bdshaffer73/RCBrains/Photos/IMG_20170501_142741.jpg

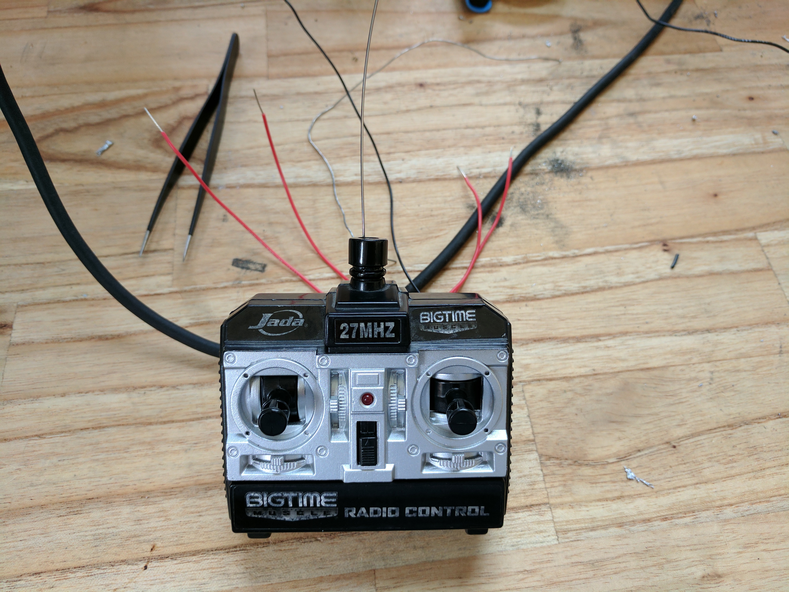
Photos/IMG_20170501_142741.jpg
