bdshaffer73/RCBrains/Photos/IMG_20170501_141757.jpg

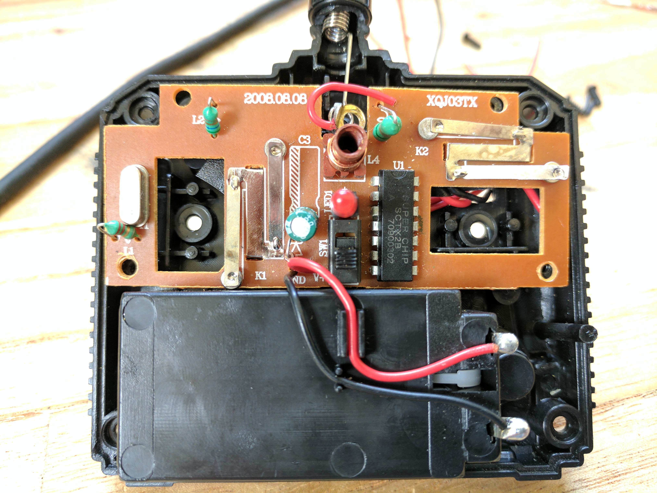
Photos/IMG_20170501_141757.jpg
