bdshaffer73/RCBrains/Photos/IMG_20170501_141855.jpg

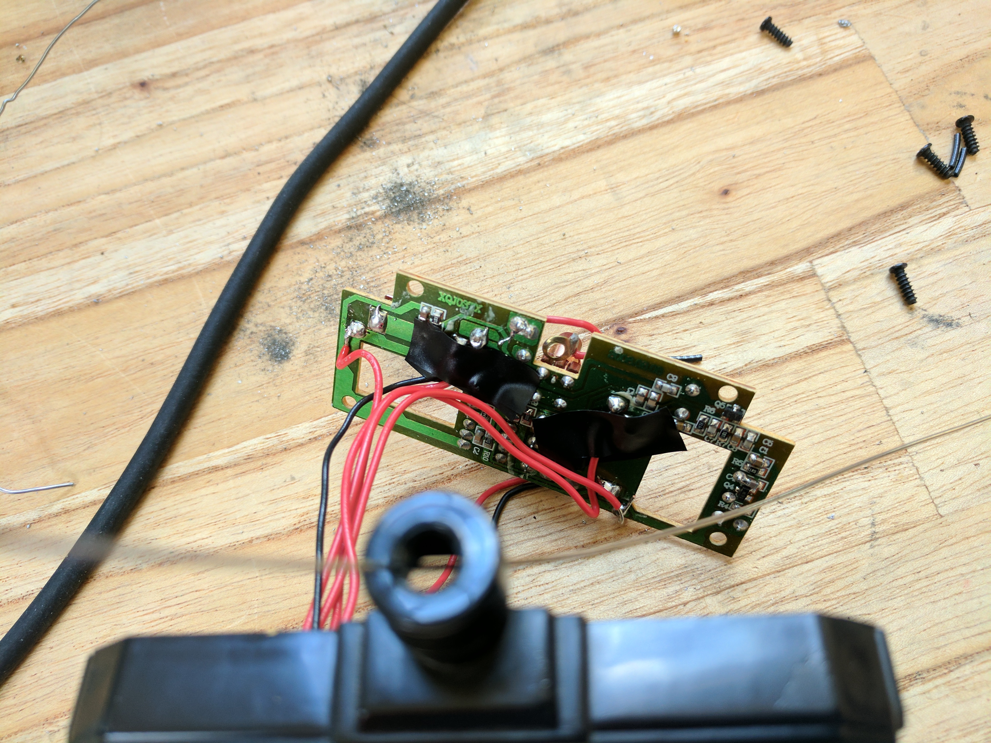
Photos/IMG_20170501_141855.jpg
